alan-od/Arduino-Frequency-Counter/Hardware/pcbs.jpg

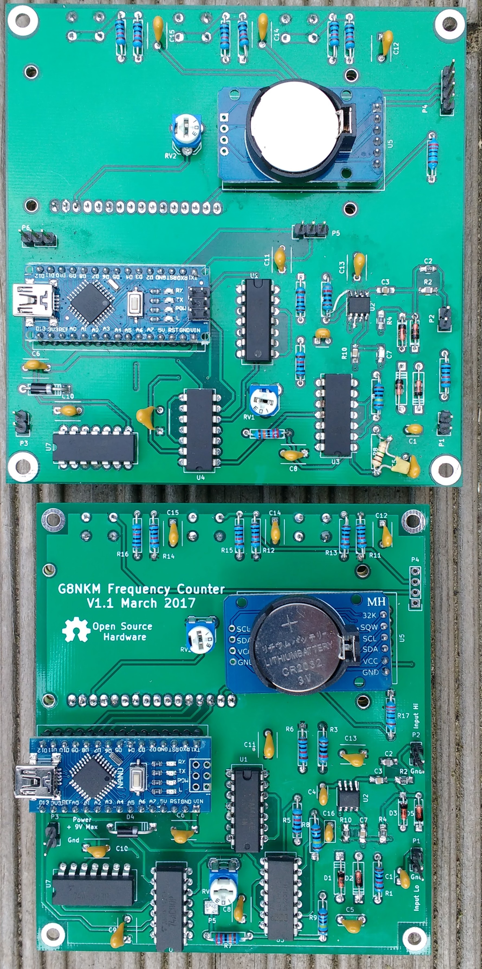
Hardware/pcbs.jpg
