alan-od/Arduino-Frequency-Counter/Hardware/clock_mode.JPG

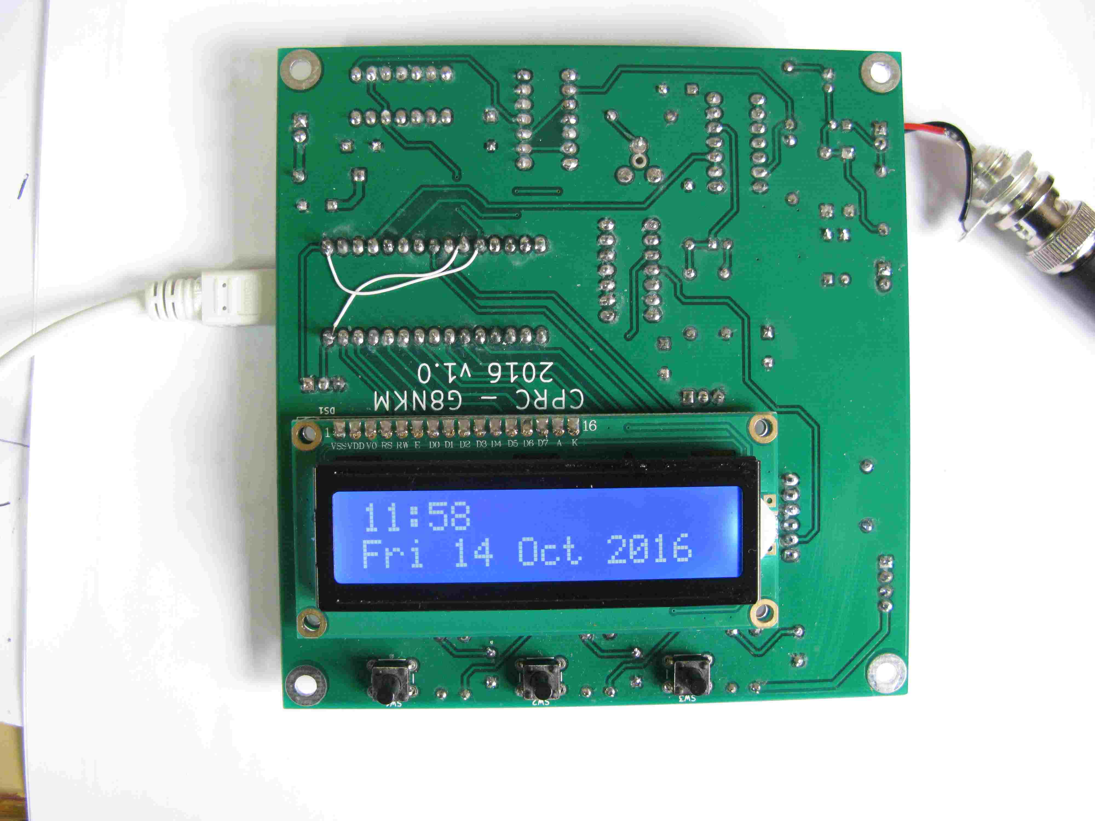
Hardware/clock_mode.JPG
