alan-od/Arduino-Frequency-Counter/Hardware/board.JPG

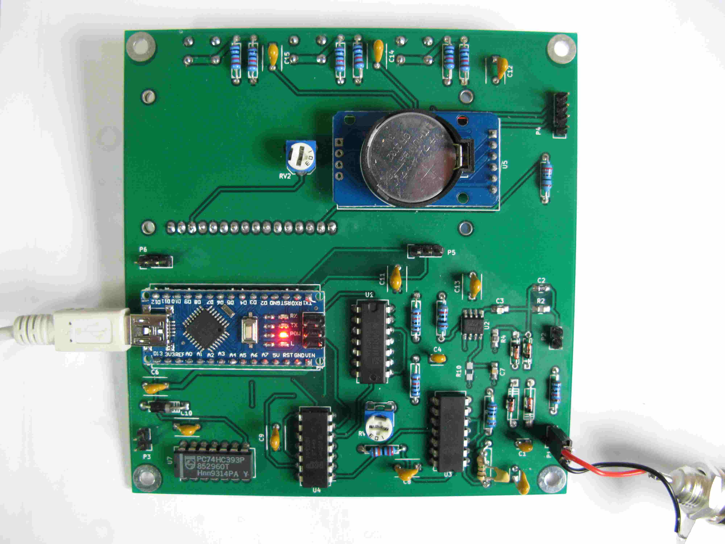
Hardware/board.JPG
