alan-od/Arduino-Frequency-Counter/Hardware/freq_mode.JPG

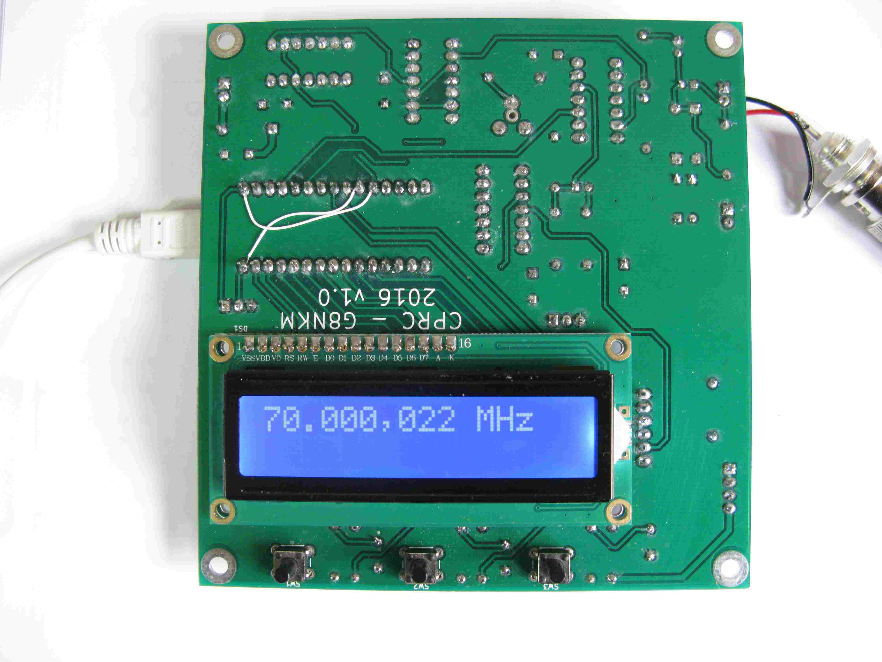
Hardware/freq_mode.JPG
