alan-od/Arduino-Frequency-Counter/Hardware/schematic.pdf

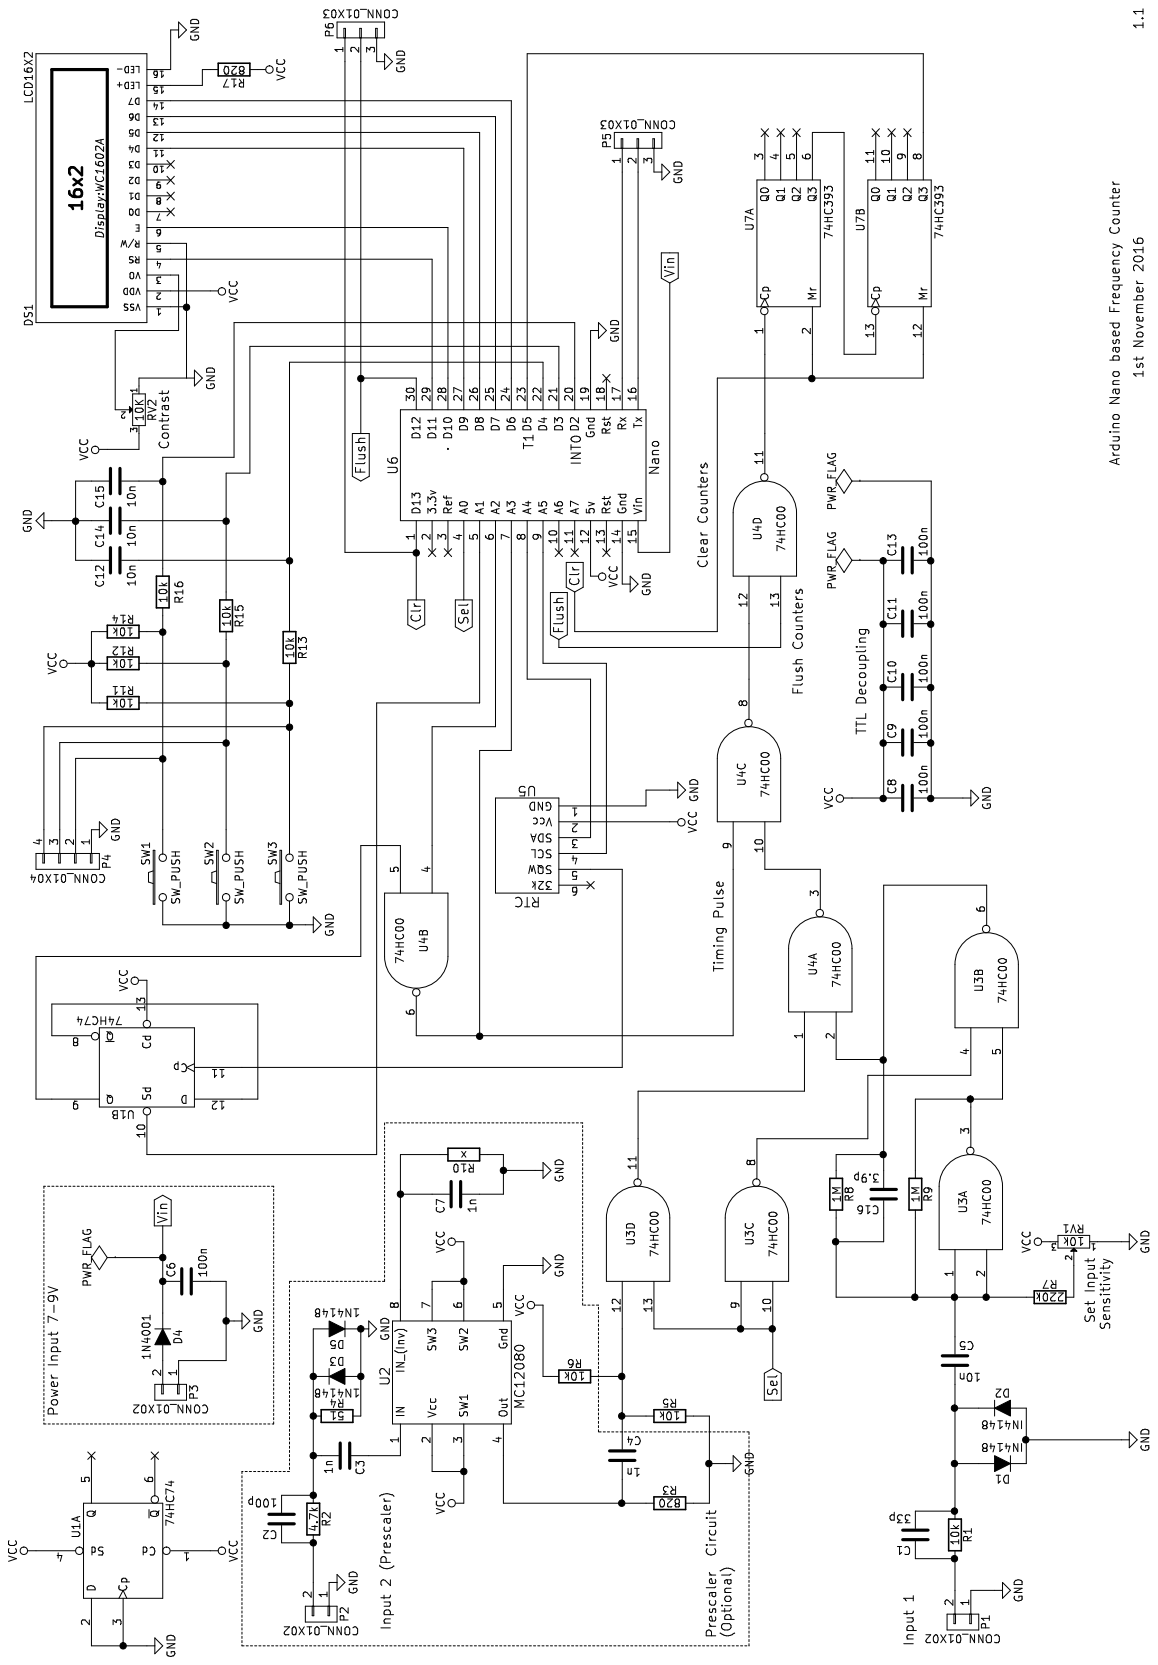
[picture p5: page 1]
