alan-od/Arduino-Frequency-Counter/(notices)

Notices in the files:
Software/Frequency_counter_v0.2/clock_function.ino:
Frequency_counter is free software: you can redistribute it and/or modify
it under the terms of the GNU General Public License as published by
the Free Software Foundation, either version 3 of the License, or
(at your option) any later version.
